Dheeresh-Vijay-Devadiga/ELectrical_MountainBoard/IMAGES:Videos/IMG_20221207_120426.jpg

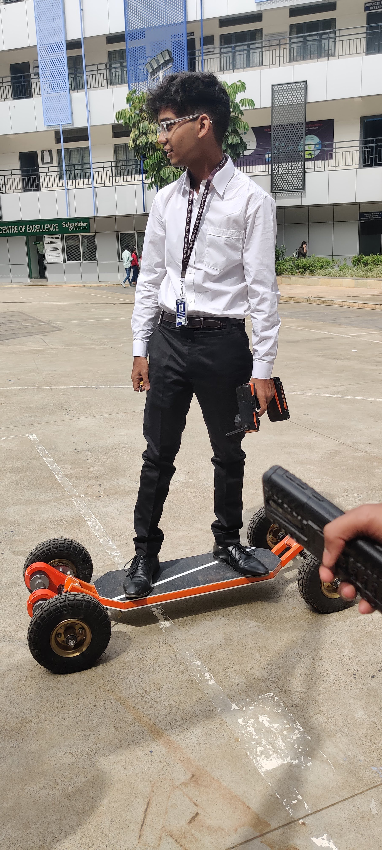
IMAGES:Videos/IMG_20221207_120426.jpg
