Dheeresh-Vijay-Devadiga/ELectrical_MountainBoard/CAD IMAGES/Back View.png

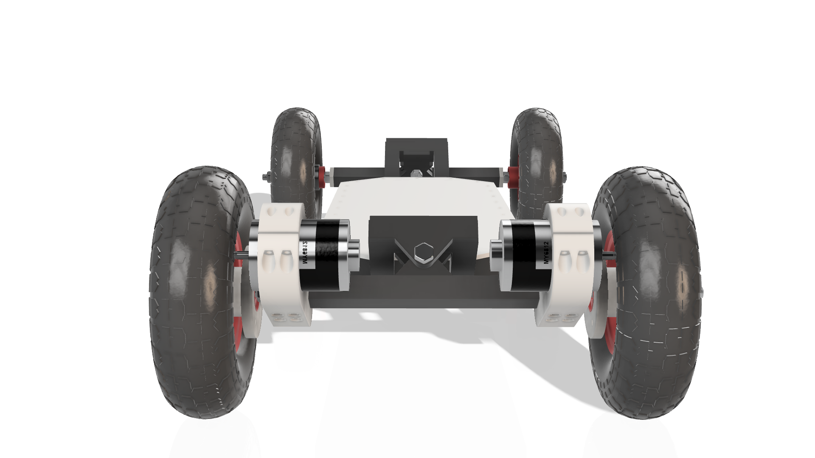
CAD IMAGES/Back View.png
