Dheeresh-Vijay-Devadiga/ELectrical_MountainBoard/CAD IMAGES/bottom view.png

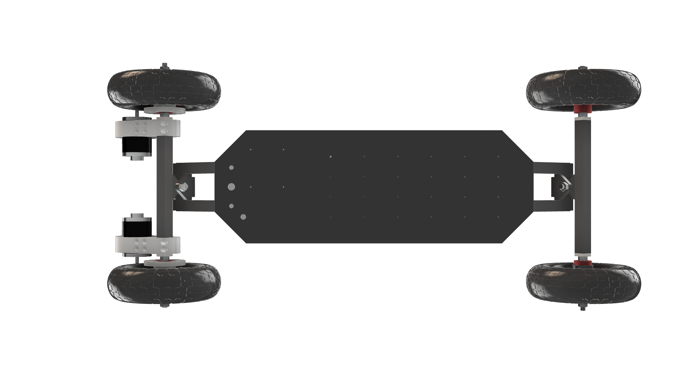
CAD IMAGES/bottom view.png
