Dheeresh-Vijay-Devadiga/ELectrical_MountainBoard/CAD IMAGES/drivetrain .png

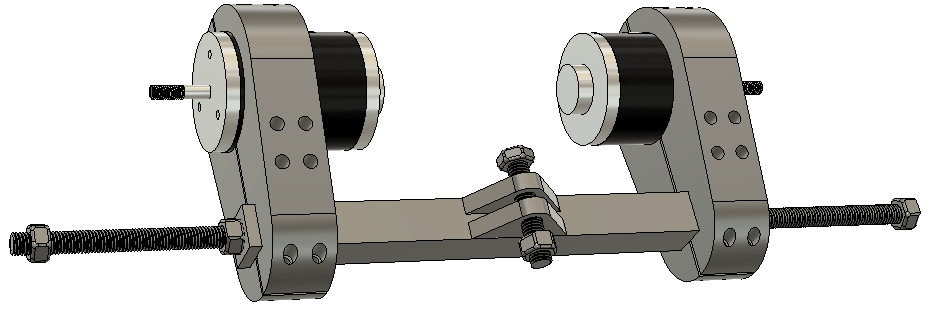
CAD IMAGES/drivetrain .png
