Dheeresh-Vijay-Devadiga/ELectrical_MountainBoard/CAD IMAGES/front view .png

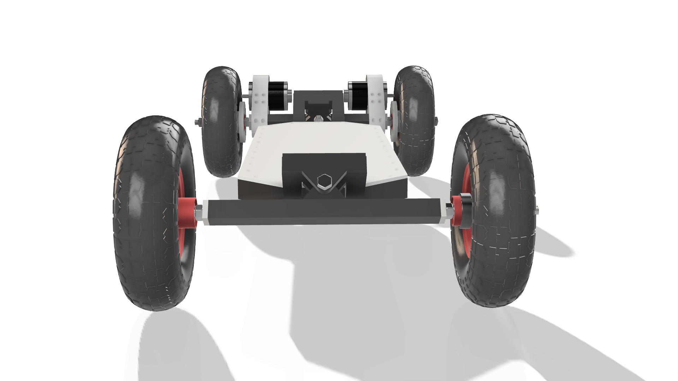
CAD IMAGES/front view .png
