Dheeresh-Vijay-Devadiga/ELectrical_MountainBoard/CAD IMAGES/refrence .png

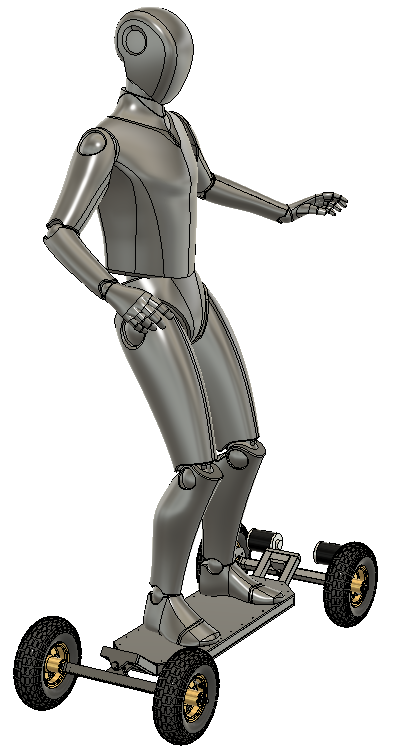
CAD IMAGES/refrence .png
