Dheeresh-Vijay-Devadiga/ELectrical_MountainBoard/CAD IMAGES/Side View.png

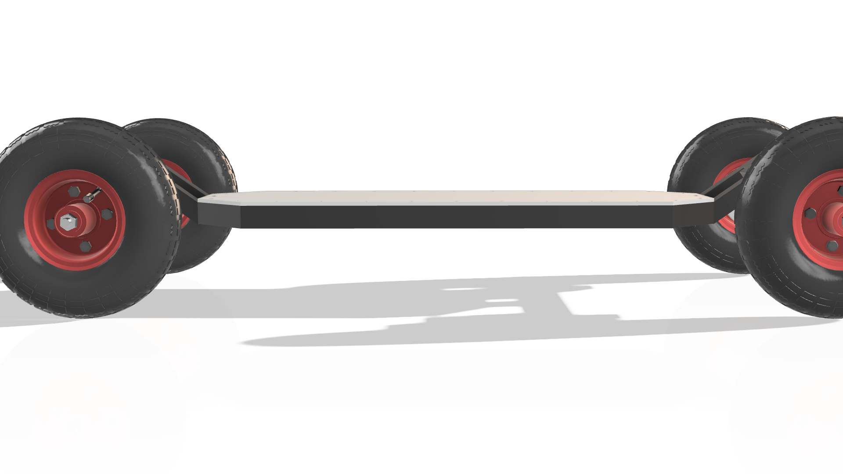
CAD IMAGES/Side View.png
