Dheeresh-Vijay-Devadiga/ELectrical_MountainBoard/CAD IMAGES/top view.png

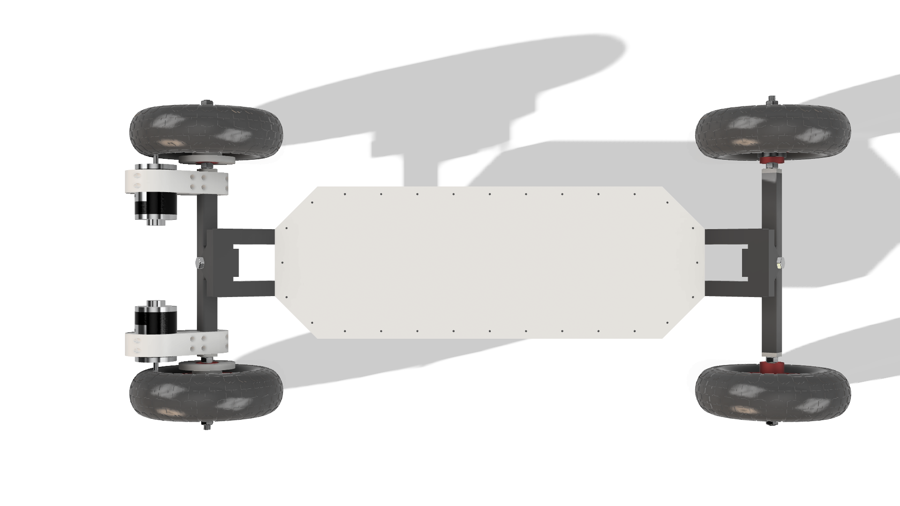
CAD IMAGES/top view.png
