Dheeresh-Vijay-Devadiga/ELectrical_MountainBoard/CAD IMAGES/vector diagram .pdf

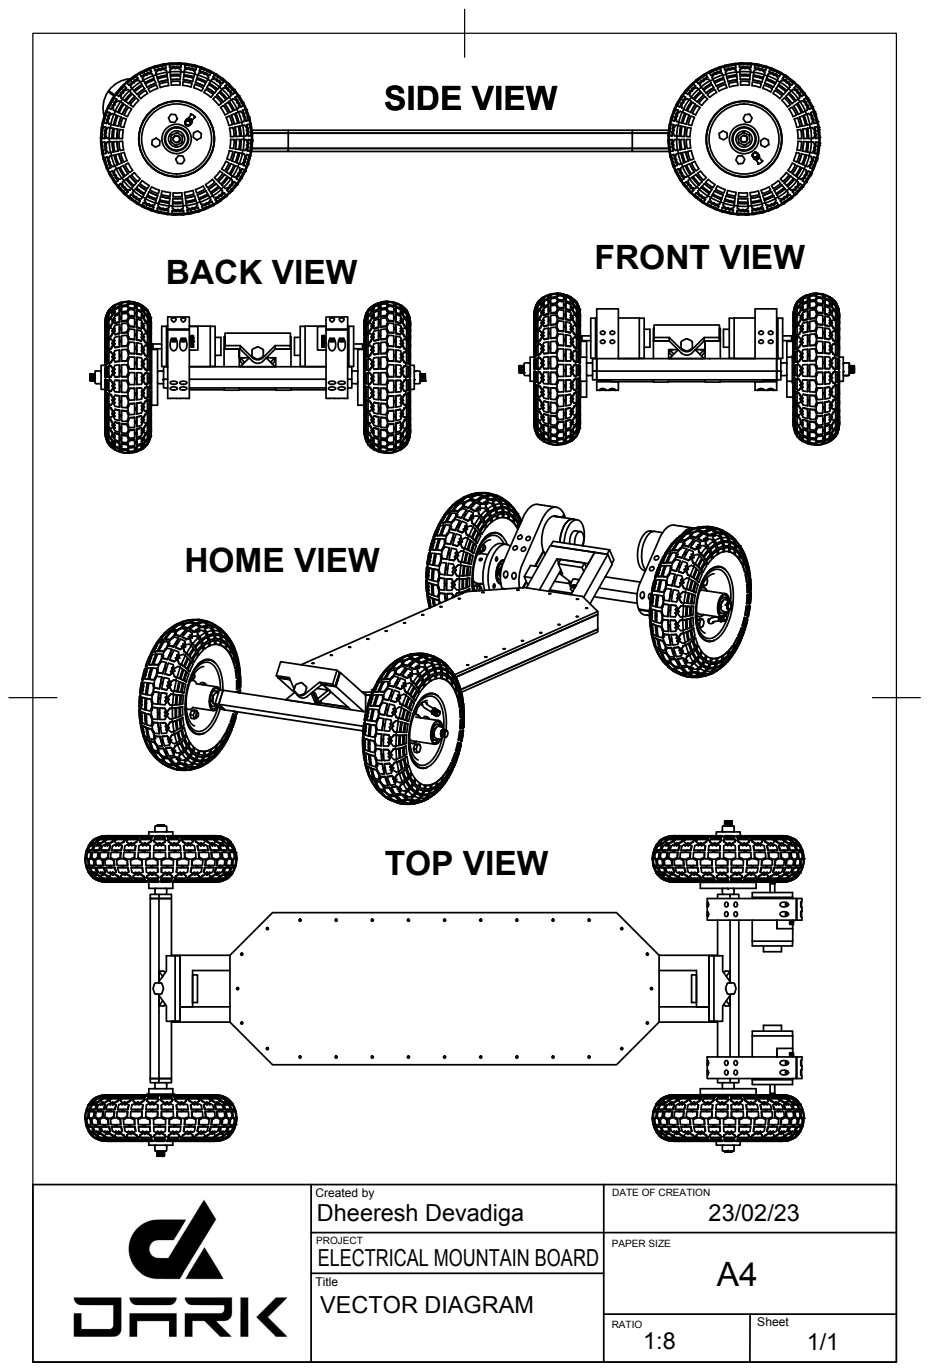
[picture p17: page 1]
Created by; PROJECT; DATE OF CREATION; PAPER SIZE RATIO; VECTOR DIAGRAM; Dheeresh Devadiga; ELECTRICAL MOUNTAIN BOARD; SIDE VIEW; BACK VIEW; HOME VIEW; FRONT VIEW; TOP VIEW
